Slider2732/ESP-909/ESP909_Circuit.png

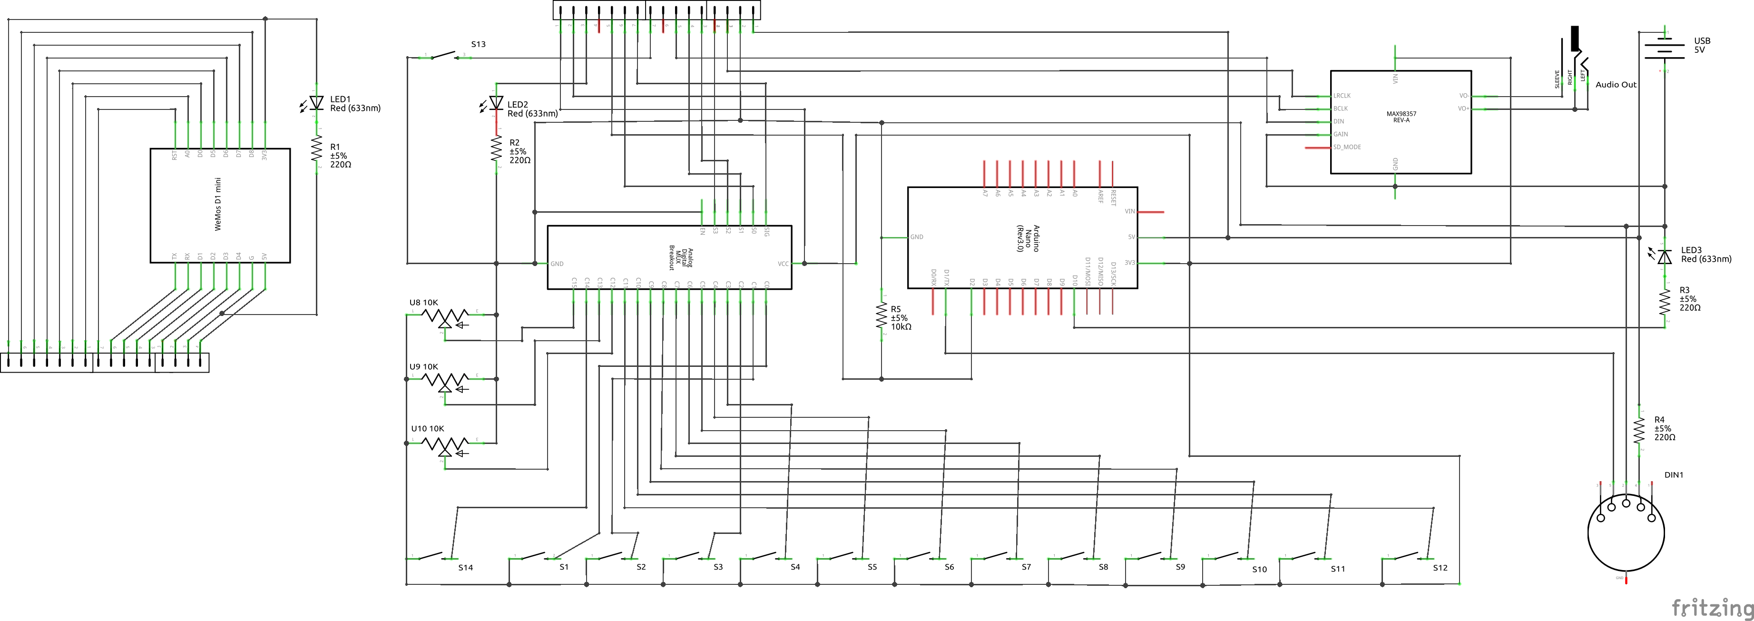
ESP909_Circuit.png
